westerndigitalcorporation/swerv_eh1/(threads)

Thread 10 (2019-02-10):

Request for simple code generation reference

rvgp, 2019-02-10:
Thanks for sharing this very impressing project.

Will it be possible to share  a simple code generation reference (from C/ASM to HEX) Such as used for generating the provided Hello-World Hex files.

More specifically I'm looking for the the boot code sequence performing initialization followed by load of the external code over the AHB and execution from the ICCM.

I manage to compile, load and execute some code, however it looks from the trace output that it is running extremely slow in terms of executed instructions per cycle (order of 0.1, stalled 90% of the cycles) even after the entire code is loaded and executing from the ICCM while the HELLO WORLD provided example  runs at reasonable performance, therefore I assume I’m missing something in my initialization sequence which I can’t figure out.

Udi

olofk, 2019-02-12:
If it helps, I disassembled the hello world example some time ago. Here's the listing (the rest of the file is just filled with nop)

    00000000 <_binary_program_bin_start>:
       0:	b0219173          	csrrw	sp,minstret,gp
       4:	ee0002b7          	lui	t0,0xee000
       8:	0002e293          	ori	t0,t0,0
       c:	30529173          	csrrw	sp,mtvec,t0
      10:	5d555337          	lui	t1,0x5d555
      14:	55536313          	ori	t1,t1,1365
      18:	7c0310f3          	csrrw	ra,0x7c0,t1
      1c:	000002b7          	lui	t0,0x0
      20:	0002e293          	ori	t0,t0,0
      24:	7f829173          	csrrw	sp,0x7f8,t0
      28:	000002b7          	lui	t0,0x0
      2c:	0002e293          	ori	t0,t0,0
      30:	7f929173          	csrrw	sp,0x7f9,t0
      34:	00000013          	nop
      38:	f0040537          	lui	a0,0xf0040
      3c:	00056513          	ori	a0,a0,0
      40:	00100013          	li	zero,1
      44:	000004b7          	lui	s1,0x0
      48:	04806493          	ori	s1,zero,72
      4c:	00108093          	addi	ra,ra,1
      50:	00108093          	addi	ra,ra,1
      54:	d05805b7          	lui	a1,0xd0580
      58:	0005e593          	ori	a1,a1,0
      5c:	000004b7          	lui	s1,0x0
      60:	0484e493          	ori	s1,s1,72
      64:	0095a023          	sw	s1,0(a1) # d0580000 <_binary_program_bin_end+0xd057fce8>
      68:	000004b7          	lui	s1,0x0
      6c:	0454e493          	ori	s1,s1,69
      70:	0095a023          	sw	s1,0(a1)
      74:	00000013          	nop
      78:	00748493          	addi	s1,s1,7 # 7 <_binary_program_bin_start+0x7>
      7c:	00000013          	nop
      80:	0095a023          	sw	s1,0(a1)
      84:	00000013          	nop
      88:	0095a023          	sw	s1,0(a1)
      8c:	00000013          	nop
      90:	00000013          	nop
      94:	00348493          	addi	s1,s1,3
      98:	00000013          	nop
      9c:	00000013          	nop
      a0:	0095a023          	sw	s1,0(a1)
      a4:	00000013          	nop
      a8:	00000013          	nop
      ac:	00000013          	nop
      b0:	000004b7          	lui	s1,0x0
      b4:	0204e493          	ori	s1,s1,32
      b8:	00000013          	nop
      bc:	0095a023          	sw	s1,0(a1)
      c0:	00000013          	nop
      c4:	03748493          	addi	s1,s1,55 # 37 <_binary_program_bin_start+0x37>
      c8:	0095a023          	sw	s1,0(a1)
      cc:	000004b7          	lui	s1,0x0
      d0:	04f4e493          	ori	s1,s1,79
      d4:	0095a023          	sw	s1,0(a1)
      d8:	00348493          	addi	s1,s1,3 # 3 <_binary_program_bin_start+0x3>
      dc:	0095a023          	sw	s1,0(a1)
      e0:	000004b7          	lui	s1,0x0
      e4:	04c4e493          	ori	s1,s1,76
      e8:	0095a023          	sw	s1,0(a1)
      ec:	000004b7          	lui	s1,0x0
      f0:	0444e493          	ori	s1,s1,68
      f4:	0095a023          	sw	s1,0(a1)

aprnath, 2019-02-12:
Hi Udi,
Thank you for your interest. We will provide the code reference shortly. Minimally you must write the MRAC CSR to enable the i-cache. We typically write 0x55555555 to enable icache for all regions.

To execute code from ICCM you need to either pre-load it (via a testbench  mechanism) or use the DMA slave port to load instructions to ICCM. The DCCM can be loaded via a memcopy() operation, in addition to the testbench and DMA methods.

rvgp, 2019-02-12:
Many thanks for both useful replies, I now manage to nicely run with the cache enabled as well as directly from the ICCM, looking forward to the mentioned code reference.

Udi.

aprnath, 2019-02-16:
Udi, I have updated the testbench to be a little more robust. Also added example assembly tests.
You should be able to run your own simple assembly tests using the instructions in the README.

rvgp, 2019-02-18:
Thanks, that is useful.
Udi

Closed 2019-02-16.

Thread 14 (2019-03-08):

Compiler option for CoreMark

lance91633, 2019-03-08:
I have tried running CoreMark on the simulator with below options provided by Syntacore
`O3 -funroll-loops -fpeel-loops -fgcse-sm -fgcse-las `
However, the performance is up to 4.1 CM/MHz
Is there any suggestion about compiler option for better performance?

Besides, is there any suggestion about hardware configuration or simulation mechanism for better performance?
Here is my hardware configuration and simulation mechanism
- Pre-load instruction in ICCM (Default size)
- I-cache enabled(Default configuration)(Using provided assembly code)
- Pre-load data in DCCM (Default size)

Thanks!

robertgolla, 2019-03-11:
Lance, there are a couple of things to check to make sure you get the right CoreMark score from rtl simulation.

First thing is exactly how are you measuring cycles for one CoreMark loop iteration?

We use perf_start and perf_end labels as shown below in the C source:

	/* perform actual benchmark */
	start_time();

	__asm("__perf_start:");

#if (MULTITHREAD>1)
	if (default_num_contexts>MULTITHREAD) {
		default_num_contexts=MULTITHREAD;
	}
	for (i=0 ; i<default_num_contexts; i++) {
		results[i].iterations=results[0].iterations;
		results[i].execs=results[0].execs;
		core_start_parallel(&results[i]);
	}
	for (i=0 ; i<default_num_contexts; i++) {
		core_stop_parallel(&results[i]);
	}
#else
	iterate(&results[0]);
#endif

	__asm("__perf_end:");

	stop_time();
	total_time=get_time();

When we measure from perf_start to perf_end in rtl simulation with the following compiler flags “-O3 -funroll-all-loops fgcse-las”, we get a CM/MHz of around 4.6 for the default configuration of swerv core.  Our small cmark2.c example has 2 iterations, so calculation is (cycle_perf_end - cycle_perf_start) / 2 for 1 iteration of CoreMark.

What do you get?

If I reconfigure the core to have more instruction cache, larger predictor

	./swerv.config -btb_size=512 -bht_size=2048 -icache_size=32

the score improves to around 4.9 CM/MHz.

lance91633, 2019-03-13:
Hi Robert,
Thank you for your respond. I stub the performance monitoring code snippet as same as yours. After you replied, I have changed my iteration number from 5 to 2.

Now, the score is improved! However, there are some difference between my results and yours. When I use provided compiler option with default configuration, I got a CM/MHz of around  4.4. If I reconfigure the core as same as you provided, I got a CM/MHz of around 4.7.

Maybe there are some difference between our memory mapping. I use the default memory mapping. Before simulation, I put the code section in ICCM(0xee000000), data section in DCCM(0xf0080000).
In addition, I noticed that the default core configuration has no ICCM. Therefore, I tried to load instruction in external Instruction memory, but the score is similar.

Besides, I tried to run Dhrystone benchmark with your hardware and compiler option. I got a DMIPS/MHz of around 2.2. Is there any other suggestion for running Dhrystone?

Thanks a lot for your response!

jrahmeh, 2019-03-14:
Hi Lance,

We compiled core-marks with gcc 7.2.0 using the following flags: -O3 -funroll-all-loops -fgcse-sm -fgcse-las -mabi=ilp32 -march=rv32imc

We put all the source code of coremarks into one file.

Joe

robertgolla, 2019-03-14:
btw, I think we need to figure out CoreMark before we switch over to Dhrystone.

Robert

robertgolla, 2019-03-15:
Lance, if you don't mind email me at robert.t.golla@gmail.com.  Thanks.

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

lance91633, 2019-03-17:
Robert,

That would be helpful, I will contact you via email.

Thanks!

lance91633, 2019-03-18:
The cause of mismatch is version of gcc
When I switch my gcc version from 8.2 to 7.2, the performance is improved!

In original config: ~4.6CM/MHz
Larger i-cache and larger BTB/BHT : ~4.9CM/MHz

Thanks a lot!

ZvonimirBandic, 2019-03-18:
Lance,
I would also quite appreciate if you publish your findings as some sort of
PDF "Application note" document, for future attempts on Coremark reqsult
replication.

Super thanks,
Z.

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

Closed 2019-03-18.

Thread 16 (2019-03-18):

'ifdef VERILATOR is commented out? how to compile for FPGA target?

AnttiLukats, 2019-03-18:
pic_ctrl.sv line 271 should allow to use 'ifdef VERILATOR to disable verilator, but this is commented out, so it is not possible to compile unless VERILATOR is defined? Does this mean that the code can not be compiled to real FPGA targets at all?

olofk, 2019-03-18:
My guess is that there was some code that verilator couldn't handle so that had to unroll it with a perl script, and now use that code for all targets. I have successfully built SweRV with modelsim, xsim, verilator and vivado using FuseSoC

robertgolla, 2019-05-03:
The comment above is correct.  The current code works with all the simulators listed above.  The commented code had issues with verilator.  Verilator supports a much smaller subset of verilog versus the commercial simulators such as incisive or vcs.

jrahmeh, 2019-05-03:
Commented code should not preclude compilation with verilator or mapping to an FPGA.

Closed 2019-05-03.

Thread 19 (2019-04-16):

Instruction fetch failure when fetching from an AXI/AHB VIP with random latency

splash3011, 2019-04-16:
Hi there:

I found that SWERV(default configuration) might have an RAS issue as below:

SWERV(default configuration) RAS push/pop are not in-pair in my test, causing speculative memory(instruction) access to illegal address range(0x0). Note that test could pass(finishing at 0x80000b64) since pipeline will realize it was a wrong prediction later and cancel it. Also because that access to the illegal address does not cause any side effect to my current simulation environment. But this could be an issue in real SOC having such unexpected read access to system. And probably there is no performance gain from the RAS when this scenario happens.

Could you please help double check?
Waveform:
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

Test code:
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

Looking forward to your response. Thanks a lot!

tmw-wdc, 2019-04-18:
Hi!  Thank you for bringing this to our attention.  We will be looking into it and report back.

splash3011, 2019-04-26:
> Hi! Thank you for bringing this to our attention. We will be looking into it and report back.

Hi! Thank you for the reply. Any update?

robertgolla, 2019-04-30:
Instruction cache misses on Swerv are speculative in nature.  The core may go out to memory speculatively for an instruction cache miss in the following cases:

1)	due to an earlier exception, interrupt
2)	due to  an earlier branch mispredict
3)	due to an incorrect branch prediction
4)	due to an incorrect RAS prediction

Generally, this is ok as long as the platform is able to handle accesses to unimplemented memory by returning data of any kind and / or a bus error condition, and prevent accesses to SOC components with read side effects.

The Swerv core does not limit speculative access in its current form.  The decision of which addresses are implemented or not is left to the platform.

robertgolla, 2019-05-01:
Another thing you can to do limit speculation is to turn off branch prediction including RAS.  If you write a 1 to bit 3 of the MFDC, branch prediction including RAS will be disabled.

Info can be found in the Swerv PRM, Section 8.1.1
8.1.1 Feature Disable Register (mfdc)
The mfdc register hosts low-level core control bits to disable specific features. This may be useful in case a feature intended to increase core performance should prove to have problems

Table 8-1 Feature Disable Register (mfdc, at CSR 0x7F9)
Field Bits Description Access Reset
Reserved 31:11 Reserved R 0
10 Dual issue disable R/W 0
9 PIC multiple interrupts disable R/W 0
8 Core ECC check disable R/W 0
7 Secondary ALU disable R/W 0
Reserved 6 Reserved R 0
5 LSU/DIV non-blocking disable R/W 0
4 Fast divide disable R/W 0
3 Branch prediction disable R/W 0
2 Write Buffer (WB) coalescing disable R/W 0
1 Load miss bypass Write Buffer (WB) disable R/W 0
0 Pipelining disable R/W 0

robertgolla, 2019-05-03:
We are currently working on providing rudimentary instruction and data access protections in the core itself.  With these protections speculative accesses as you describe above to the bus would no longer occur.  We hope to validate this in the near future and release to github shortly along with documentation about how the protection mechanism works.

splash3011, 2019-05-04:
Hi robertgolla:

Thanks a lot for your replies:)

May I ask when we can expect the release you mentioned?  Because I think for a dual-issue 9-stage high performance core, turning off the whole branch prediction feature is not a good choice for causing too much performance drop.

robertgolla, 2019-05-08:
Plan is to have this feature released by the end of May.

splash3011, 2019-05-09:
@robertgolla got it! Looking forward to your release and thank you so much for your effort:)

splash3011, 2019-06-03:
Hi @robertgolla hope all is well：） Any update on the new release?

robertgolla, 2019-06-06:
Release 1.1 is there now.  Give it a try and let us know.

splash3011, 2019-06-06:
@robertgolla Got it! Thanks a lot for your effort:)

robertgolla, 2019-06-06:
btw, if you look at section 14.1.2 of the PRM you can now define up to 8 instruction access windows as build arguments.  IF you define 1 or more of these windows, then for any access to a non-CCM region these access window rules will apply.  Any access outside these windows will be an instruction access fault.  Since these are build args, user can make sure there are no speculative instruction accesses using access windows coming out of reset.

There is a similar mechanism for data accesses though on EH1 all load / store bus accesses are non-speculative.

14.1.2 Memory Protection Build Arguments
• Instructions
o Instruction Access Window x (x = 0..7)
▪ Enable (INST_ACCESS_ENABLEx): 0,1 (0 = window disabled; 1 = window enabled)
▪ Base address (INST_ACCESS_ADDRx): 0x0000_0000..0xFFFF_FFC0 (see Section
14.1.1)
▪ Mask (INST_ACCESS_MASKx): 0x0000_003F..0xFFFF_FFFF (see Section 14.1.1)
• Data
o Data Access Window x (x = 0..7)
▪ Enable (DATA_ACCESS_ENABLEx): 0,1 (0 = window disabled; 1 = window enabled)
▪ Base address (DATA_ACCESS_ADDRx): 0x0000_0000..0xFFFF_FFC0 (see Section
14.1.1)
▪ Mask (DATA_ACCESS_MASKx): 0x0000_003F..0xFFFF_FFFF (see Section 14.1.1)

Thread 20 (2019-04-30):

getting VCS run error

mayank2016, 2019-04-30:
Hello Swerv Team
i am getting error when  i am running make file for vcs-run
..........
..........
Parsing design file '/home/mayank/RISCV_MAYANK/swerv_eh1/design/dbg/dbg.sv'
Parsing included file '/home/mayank/RISCV_MAYANK/swerv_eh1/configs/snapshots/default/defines.h'.

Error-[SE] Syntax error
  Following verilog source has syntax error :
  "/home/mayank/RISCV_MAYANK/swerv_eh1/configs/snapshots/default/defines.h",
  6: token is '#'
  #define RV_IFU_BUS_TAG 3
   ^

1 error
CPU time: .269 seconds to compile
make: *** [vcs] Error 255
[mayank@g3 swerv_eh1]$ ^C
[mayank@g3 swerv_eh1]$

thanks & regards
mayank

aprnath, 2019-04-30:
Mayank, please use the desig/flist.vcs file or look at the vcs build/run command in the tools/Makefile for a valid vcs command line.

Defines.h is NOT a verilog/systemveilog file. It is for C/Assembly defines.

mayank2016, 2019-05-01:
Hello aprnath
      defines.h is C/Assembly defines but used here with module dbg
Code Snippet :------
//********************************************************************************
// $Id$
//
// Function: Top level SWERV core file to control the debug mode
// Comments: Responsible to put the rest of the core in quiesce mode,
//           Send the commands/address. sends WrData and Recieve read Data.
//           And then Resume the core to do the normal mode
// Author  :
//********************************************************************************
`include "defines.h"
`include "global.h"
module dbg (
   // outputs to the core for command and data interface
   output logic [31:0]                 dbg_cmd_addr,
   output logic [31:0]                 dbg_cmd_wrdata,
   output logic                        dbg_cmd_valid,
   output logic                        dbg_cmd_write, // 1: write command, 0: read_command
   output logic [1:0]                  dbg_cmd_type, // 0:gpr 1:csr 2: memory
   output logic [1:0]                  dbg_cmd_size, // size of the abstract mem access debug command
   output logic                        dbg_core_rst_l, // core reset from dm

   // inputs back from the core/dec
   input logic [31:0]                  core_dbg_rddata,
   input logic                         core_dbg_cmd_done, // This will be treated like a valid signal
   input logic                         core_dbg_cmd_fail, // Exception during command run

   // Signals to dma to get a bubble
   output logic                        dbg_dma_bubble,   // Debug needs a bubble to send a valid
   input  logic                        dma_dbg_ready,    // DMA is ready to accept debug request
   --------------------------------------------------------------------
------------------------------------------------------------------------
//---------------------rest of code-----------------------------------------------

i am using "$RV_ROOT/tools/Makefile vcs-run"  command and i don't know why it is using C defines here and giving error.

thanks & regards
Mayank

aprnath, 2019-05-01:
Hi Mayank,

I don't see any (and there shouldn't be any) `include defines.h ` in the dbg.sv file, or any design file. Is this something you added after getting the source?

In fact the original source only has `include "global.h"` after the module port definition.
```

module dbg (
   // outputs to the core for command and data interface
output logic [31:0] dbg_cmd_addr,
  :
  :
     input logic                         scan_mode
);

`include "global.h"

typedef enum ....

```

Please recheck your copy against the source.

mayank2016, 2019-05-01:
Sorry aprnath , It was my mistake,
           it is working fine for vcs. Actually i tried to implement whole
SOC in FPGA. Otherwise it is only up to simulation level. That time i found
that global.h also required `define which were in script generated
defines.h . So i included here , But i got that common_defines.vh should be
included here. same defines are used for sv and C ,just file name is
different.
Have you implemented Swerv in FPGA ? or i am thinking in wrong direction ,
Please let me know.

Sorry for inconvenience

Thanks & Regards
Mayank

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

aprnath, 2019-05-01:
Mayank, yes, we have built SweRV on several FPGA platforms. Please see https://github.com/westerndigitalcorporation/swerv_eh1_fpga for our public recipe for an FPGA build of SweRV.

mayank2016, 2019-05-01:
Thanks a lot aprnath

regards
Mayank

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

mayank2016, 2019-05-01:
Thanks a lot aprnath

regards
Mayank

Closed 2019-05-01.

Thread 21 (2019-05-14):

SWERV IFU access ITCM/ROM may get DMA（SOC）also accessing ITCM/ROM starved

ryan0301, 2019-05-14:
Hi there:
I found one deadlock scenario when applying SWERV core in SoC as below:

What expected is that after core configures DMA to transfer data in between itcm and external SRAM in SoC, core then waits DMA to complete transferring before processing further. However, DMA cannot access itcm through Core dma slave interface since itcm is occupied in use by IFU, which introduces deadlock as failure.

//==============
// C Source Code
//==============
main（void）{
//configure DMA
......
  while(dma_ch2_done==0);  //dma_ch2_done is asserted in DMA interrupt handler after completing transfer data from ITCM to SRAM
.......};

//==============
// Assemble Code    //corresponding to  "while(dma_ch2_done==0)" C Source code
//==============
2000195a:	67c5                	lui	a5,0x11
2000195c:	7747a783        lw	a5,1908(a5) # 11774 <dma_ch2_done>
20001960:	dfed                	beqz	a5,2000195a <main+0x40>

//==============
// Waveform
//==============
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

From the waveform we can observe that IFU access ITCM in loop for the above three instruction codes and it takes priority over DMA accessing ITCM, in this case, DMA can never complete the data transfer.

//==============
// Suggest Solution
//==============
Any HW solution to prevent starvation when both core dma slave ports and ifu access itcm simultaneously？ such as round-robin strategy applied when access conflict occurs or counter threshold strategy to prevent starvation and deadlock

 Thanks a lot!

Looking forwards to your reply.

aprnath, 2019-05-14:
Hi,

Could you clarify that you are executing code **from the ICCM**, while also loading the ICCM via DMA? Or are you executing code from external/cacheable memory while loading the ICCM via DMA?

Could you try adding a 'pause' in the tight while loop, or even a 'halt' (the interrupt should allow exit from halt).

robertgolla, 2019-05-14:
We found this issue a few months back and the fix will be in the next release currently targeted for end of this month (5/31).    Thanks for bringing this to our attention.

robertgolla, 2019-05-15:
Ryan, can you please contact me at robert.t.golla@gmail.com.  We want to see if we can get more details about this ICCM/dma issue.

ryan0301, 2019-05-20:
Hi Robert,

I send the email to u and also paste it here FYI. Actually we put ROM inside the core subsystem to boost performance and ROM shares the same IFU/DMA access interface with ICCM. And we make minor update to distinguish whether to access ROM or ICCM according to the address mapping afterwards. The deadlock occurs when IFU access ROM while DMA transfers data in between external sram and ICCM. Besides, even we put ROM on external system bus as you did, the deadlock could also happen to the ICCM in the case that we put code on the ICCM(such as half lower range of ICCM) while configuring DMA to transfer data in between external sram and ICCM(the other half higher range of ICCM). If any other info you need, pls. let me know. Thanks.

BR
Ryan

robertgolla, 2019-05-20:
We are fairly confident that the issues you have observed have been resolved in the upcoming release of eh1 targeted on or around 5/31.  Our recommendation at this point is to wait for this release and then give it a try.  If it works, great.  If it doesn’t, we’ll work with you more closely to see if we can resolve the issue.

ryan0301, 2019-05-21:
Thanks for your effort. We will try it based on the upcoming release database and update u later.

robertgolla, 2019-06-06:
1.1 release is now there.  Give it a try and let us know.

Thread 23 (2019-05-28):

how assembly file helloworld2.s is converted in .hex file

mayank2016, 2019-05-28:
Hello SwerV team
I did not get which gcc instruction is used for conversion of assembly file to hex file.

Please help regarding this.

thanks & regards
Mayank

aprnath, 2019-05-28:
Mayank, please check your source hello.s file. It should not have any 64 bit mnemonics (ld, sd are 64 bit load/stores, and not supported by **-march=rv32imc**).

The Makefile (in $RV_ROOT/tools/Makefile) shows the steps to create the required hex files.

```
program.hex: $(ASM_TEST_DIR)/$(ASM_TEST).s ${RV_ROOT}/configs/snapshots/$(snapshot)/common_defines.vh
    @echo Building $(ASM_TEST)
ifeq ($(shell which $(GCC_PREFIX)-as),)
    @echo " !!! No $(GCC_PREFIX)-as in path, using canned hex files !!"
    cp ${RV_ROOT}/testbench/hex/*.hex .
else
    cp $(ASM_TEST_DIR)/$(ASM_TEST).s .
    $(GCC_PREFIX)-cpp   -I${RV_ROOT}/configs/snapshots/$(snapshot)  $(ASM_TEST).s  > $(ASM_TEST).cpp.s
    $(GCC_PREFIX)-as -march=rv32imc $(ASM_TEST).cpp.s -o $(ASM_TEST).o
    $(GCC_PREFIX)-ld -m elf32lriscv --discard-none -T${RV_ROOT}/testbench/link.ld -o $(ASM_TEST).exe $(ASM_TEST).o
    $(GCC_PREFIX)-objcopy -O verilog --only-section ".data*" --only-section ".rodata*" $(ASM_TEST).exe data.hex
    $(GCC_PREFIX)-objcopy -O verilog --only-section ".text*" --set-start=0x0 $(ASM_TEST).exe program.hex
    $(GCC_PREFIX)-objdump -dS $(ASM_TEST).exe > $(ASM_TEST).dis
    $(GCC_PREFIX)-nm -f posix -C $(ASM_TEST).exe > $(ASM_TEST).tbl
    @echo Completed building $(ASM_TEST)
endif

```

mayank2016, 2019-05-28:
Thank you sir

Now I have one question
Can I connect any IP with LSU AXI master interface of swerv.
If yes, swerv core can write data in to register of IP like ARM processor
can write data on IP's register through software interface with C API.

Thanks & regards
Mayank

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

aprnath, 2019-05-29:
Yes, you should be able to connect any memory addressable IP directly, or via an interconnect matrix to the LSU AXI bus.

There is a [SweRV FPGA build](https://github.com/westerndigitalcorporation/swerv_eh1_fpga) provided by us which has an example that you may be able to reference.

mayank2016, 2019-06-07:
Sir,
I write C code to read and write in module my_register. C code will execute
inside riscv swerv.
converted C code to assembly from Riscv gcc compiler.
Swerv connected with module my_Register with lsu_AHB interface in a new top
module, add top file in flist.vcs
follow make file and generate program.hex .
Make file vcs-run command in terminal to simulate.
but value is not going to store internal reg q of module with C-api
Reg_write(address,data), i am checking value with $monitor inside
my_register module.

so where can i debug haddrr, hready ,.... signals inside SWERV. actually
where reg_write address value will be store in swerv after assembly
instruction executed? i am stuck.

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

Thread 31 (2019-09-03):

Issues to enable DMA for SweRV

rajoogupta, 2019-09-03:
Hi,
     I am trying to enable DMA for SweRV. I did following changes in **testbench/tb_top.sv**
  1. added following signal
   logic        [31:0]                 dma_haddr;
   logic        [2:0]                   dma_hburst;
   logic        [3:0]                   dma_hprot;
   logic        [2:0]                   dma_hsize;
   logic        [1:0]                   dma_htrans;
   logic                                dma_hmastlock;
   logic                                dma_hwrite;
   wire                                 dma_hresp_out;

2. port mapping
// DMA Slave
//---------------------------------------------------------------
           .dma_haddr          ('0) **replaced with**   (  dma_haddr ),   
           .dma_hburst         ('0) **replaced with**    (  dma_hburst  ),
           .dma_hmastlock     ('0) **replaced with**  (  dma_hmastlock),
           .dma_hprot             ('0) **replaced with**  (  dma_hprot ),
           .dma_hsize            ('0) **replaced with**   (  dma_hsize),
           .dma_htrans           ('0) **replaced with**   (  dma_htrans),
           .dma_hwrite           ('0) **replaced with**   (  dma_hwrite ),
           .dma_hwdata          ('0) **replaced with**   (  dma_hwdata ),

           .dma_hrdata          ( dma_hrdata    ),
           .dma_hresp          (dma_out)   **replaced with**   ( dma_hresp_out   ),
           .dma_hsel            ( 1'b1            ),
           .dma_hreadyin        ( dma_hready_out  ),
           .dma_hreadyout       ( dma_hready_out  ),

3. added instance
ahb_sif  **o_ahb_dma** (          

     .HWDATA(dma_hwdata),
     .HCLK(core_clk),
     .HSEL(1'b1),
     .HPROT(dma_hprot),
     .HWRITE(dma_hwrite),
     .HTRANS(dma_htrans),
     .HSIZE(dma_hsize),
     .HREADY(dma_hready),
     .HRESETn(reset_l),
     .HADDR(dma_haddr),
     .HBURST(dma_hburst),

     .HREADYOUT(dma_hready),
     .HRESP(dma_hresp),
     .HRDATA(dma_hrdata)

    );

after all , ran verilator and got hello world  but DMA is not enable as ICCM and DCCM donot getting any data.
Here is GTKwave for reference
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.

Please help me, to enable DMA for SweRV.

Thanks & Regards
Rajoo

aprnath, 2019-09-04:
Hello.

**Please post questions/issues on the ChipsAlliance site (https://github.com/chipsalliance/Cores-SweRV).**

The SweRV core's DMA port is a slave. It requires an external DMA agent to pull or push data from/into the ICCM/DCCM.

From the code snippet you have provided I am not able to make out if you have a valid DMA master hooked up to drive read or write requests into the internal memories.

rajoogupta, 2019-09-04:
Thanks Aprnath
I have DMA master (DMA controller) to drive read and write into the internal memories.
I will post this issue on ChipsAlliance site

Thanks & Regards
Rajoo

Closed 2019-09-06.

Thread 32 (2019-09-05):

How to get the complete trace log

taoliug, 2019-09-05:
It seems like the current external trace interface doesn't provide the execution result of each instruction. Is there a way to get the full trace information including the architectural state changes?
https://github.com/westerndigitalcorporation/swerv_eh1/blob/master/design/swerv.sv#L34

aprnath, 2019-09-06:
This repository is deprecated. Please use the [Chip Alliance](https://github.com/chipsalliance/Cores-SweRV) repository to post questions/issues.

aprnath, 2019-09-08:
Hi, I have pushed (to the Chip Alliance repo) an update to the testbench that dumps a very simple/basic execution trace (time, pc, opcode, regnum, value) to exec.log. You can use this to extend to a more detailed trace for your TB.

Please continue to post queries on the Chip Alliance site.

Closed 2019-09-06.

Thread 35 (2019-10-19):

Get confused by doc 《RISC-V_SweRV_EH1_PRM.pdf》

walkingjian, 2019-10-19:
Hi，SwerV team
    I'm try swerv_eh1_fpga database, and I can compile the "helloworld" example build, but in this project，I'm confused by external ram base address,
        1.   "swerv_eh1_fpga/software/bsp/link.ld" show the ram(to contain .text .data .stack) ‘s base address is 0x0；
        2. doc 《RISC-V_SweRV_EH1_PRM.pdf》show that swerv core's address map in section 2.8, and the address 0x0~0x0fff_ffff contain ICCM/DCCM/Reserverd Section;
        so, is it all right that riscv tool-chain use 0x0 as the start address of extern ram in this build? I'm confused by this conflict, please give me some tip, thanks a lot from an RISCV fan

tmw-wdc, 2019-10-21:
Hi!

Thank you for your question.  Please note that the open-source SweRV core repository has moved to [Chip Alliance](https://github.com/chipsalliance/Cores-SweRV) and this repository is deprecated.  Please post future questions and comments to the new repository.

Table 2-10 _SweRV EH1 Memory Address Map (Example)_ is just an example of a memory address map.  The core provides a lot of flexibility where in memory the different components may be placed, with some restrictions documented in Section 2.3.3.

Hope this helps.

Kind regards,
Thomas

walkingjian, 2019-10-22:
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

Thanks a lot, and I get this repository from  "SweRV EH1" hyperlink in "https://riscv.org/risc-v-cores/"

tmw-wdc, 2019-10-22:
Thank you for letting me know where you got the link to SweRV EH1 from.  I'll look into how to have this fixed on the riscv.org page.

Kind regards,
Thomas

Closed 2019-10-22.
