westerndigitalcorporation/swerv_eh1/(commit log)

2019-02-16 Updated testbench to execute assembly files Makefile with merges from PR #11 Added targets to make just the test
2019-02-19 Fixes to allow simulations for irun to work properly Testbench needs to be re-written to work without so many ifdef VERILATORs
    [ahb_sif.sv]
